yanntotchoun/Multi-Sensor-Node/PCB/conn&Buttons.kicad_sch

## KiCad design PCB/conn&Buttons.kicad_sch (2026-09-08)

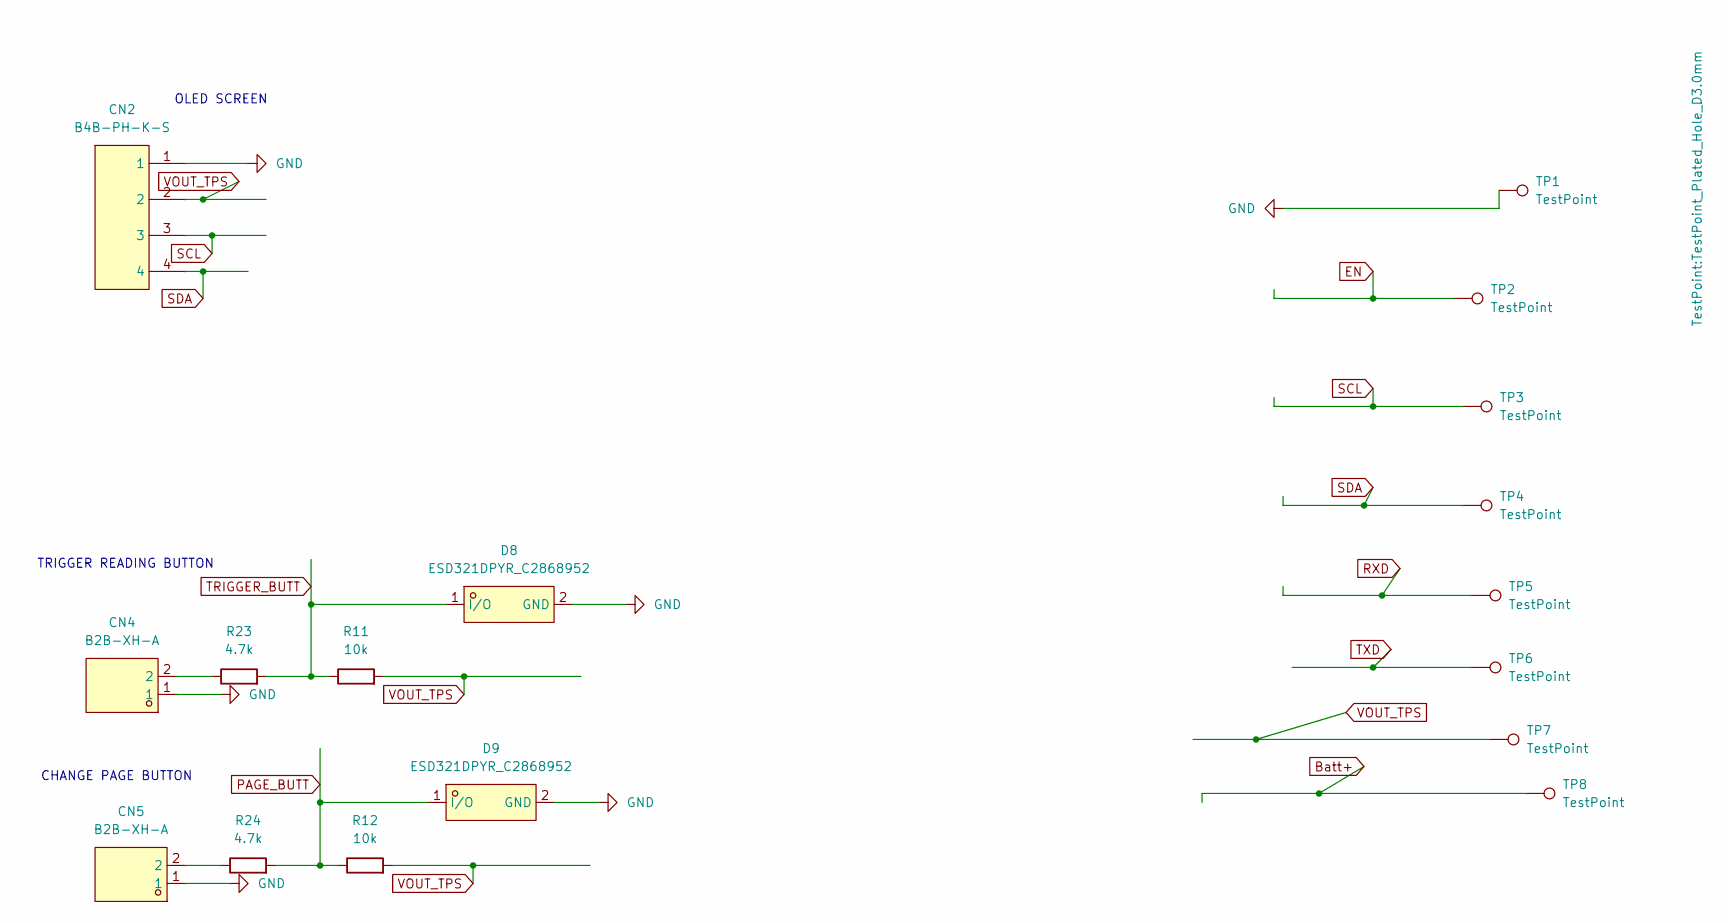
[picture p1: schematic conn&Buttons.kicad_sch]

Parts:
CN2: B4B-PH-K-S; CONN-TH_B4B-PH-K-S; MPN B4B-PH-K-S(LF)(SN); LCSC Part C131334
CN4, CN5: B2B-XH-A; CONN-TH_B2B-XH-A-LF-SN; MPN B2B-XH-A(LF)(SN); LCSC Part C158012
D8, D9: ESD321DPYR_C2868952; X1SON-2_L1.0-W0.6-P0.65-RD-1; MPN ESD321DPYR; LCSC Part C2868952
R11, R12: 10k; R_Axial_DIN0207_L6.3mm_D2.5mm_P10.16mm_Horizontal; JLCPCB C57436
R23, R24: 4.7k; R_Axial_DIN0207_L6.3mm_D2.5mm_P10.16mm_Horizontal; JLCPCB Part # C58678
TP1: TestPoint; TestPoint_Plated_Hole_D3.0mm
TP2, TP3, TP4, TP5, TP6, TP7, TP8: TestPoint; TestPoint_Pad_D2.0mm

Connections:
Batt+: TP8.1
EN: TP2.1
GND: CN2.1, CN4.1, CN5.1, D8.2 (GND), D9.2 (GND), TP1.1
unnamed: CN4.2, R23.1
unnamed: CN5.2, R24.1
PAGE_BUTT: D9.1 (I/O), R12.1, R24.2
RXD: TP5.1
SCL: CN2.3, TP3.1
SDA: CN2.4, TP4.1
TRIGGER_BUTT: D8.1 (I/O), R11.1, R23.2
TXD: TP6.1
VOUT_TPS: CN2.2, R11.2, R12.2, TP7.1

Notes on the sheet:
OLED SCREEN
TRIGGER READING BUTTON
CHANGE PAGE BUTTON
