yanntotchoun/Multi-Sensor-Node/PCB/esp32.kicad_sch

## KiCad design PCB/esp32.kicad_sch (2026-09-08)

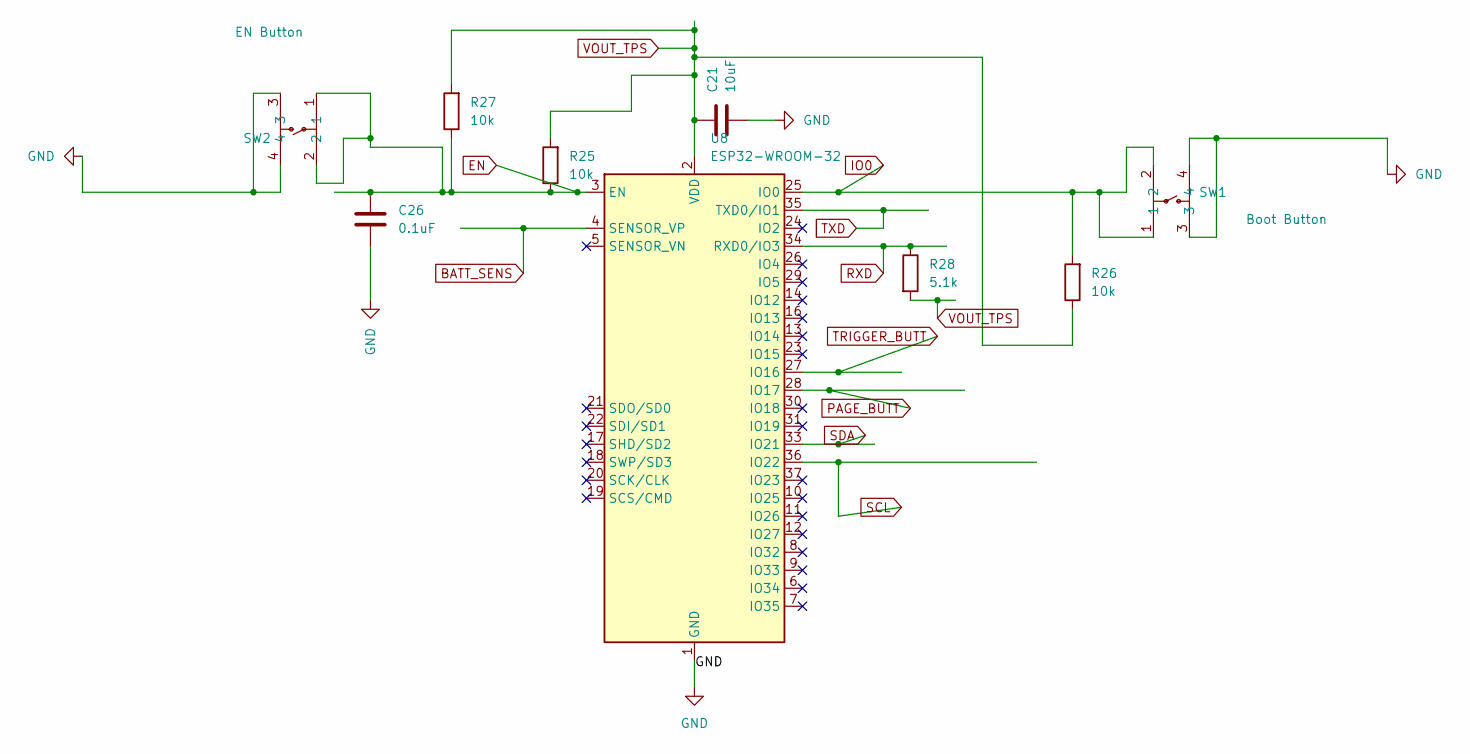
[picture p2: schematic esp32.kicad_sch]

Parts:
C21: 10uF; C_Disc_D6.0mm_W2.5mm_P5.00mm; Part Number FG20X7R1H106KRT06
C26: 0.1uF; C_Disc_D3.8mm_W2.6mm_P2.50mm; Part Number K104K15X7RF5TL2
R25, R26, R27: 10k; R_Axial_DIN0207_L6.3mm_D2.5mm_P10.16mm_Horizontal; JLCPCB C57436
R28: 5.1k; RES-TH_BD2.3-L6.5-P10.50-D0.5; LCSC Part # C714010
SW1: Boot Button; SW-TH_4P-L12.0-W12.0-P5.00-LS12.5; MPN TS1103S-12x12x7.5DIP; LCSC Part C48677982
SW2: EN Button; SW-TH_4P-L12.0-W12.0-P5.00-LS12.5; MPN TS1103S-12x12x7.5DIP; LCSC Part C48677982
U8: ESP32-WROOM-32

Connections:
BATT_SENS: U8.4 (SENSOR_VP)
EN: C26.1, R25.1, R27.1, SW2.1, SW2.2, U8.3 (EN)
GND: C21.2, C26.2, SW1.3, SW1.4, SW2.3, SW2.4, U8.1 (GND), U8.15 (GND), U8.38 (GND), U8.39 (GND)
IO0: R26.2, SW1.1, SW1.2, U8.25 (IO0)
PAGE_BUTT: U8.28 (IO17)
RXD: R28.1, U8.34 (RXD0/IO3)
SCL: U8.36 (IO22)
SDA: U8.33 (IO21)
TRIGGER_BUTT: U8.27 (IO16)
TXD: U8.35 (TXD0/IO1)
VOUT_TPS: C21.1, R25.2, R26.1, R27.2, R28.2, U8.2 (VDD)
