yanntotchoun/Multi-Sensor-Node/PCB/peripherals.kicad_sch

## KiCad design PCB/peripherals.kicad_sch (2026-09-08)

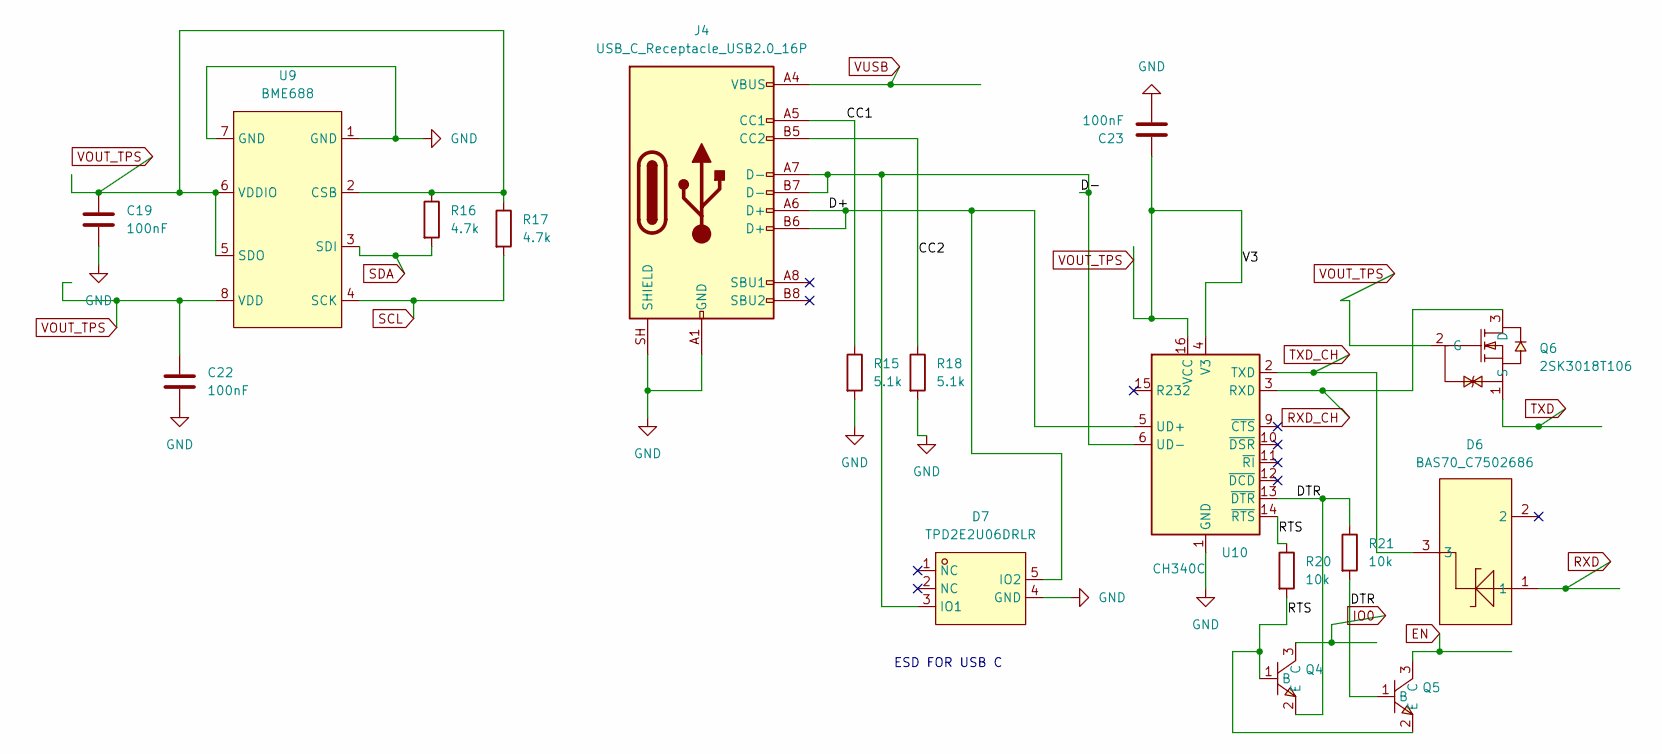
[picture p3: schematic peripherals.kicad_sch]

Parts:
C19, C22, C23: 100nF; C_0402_1005Metric
D6: BAS70_C7502686; SOT-23-3_L2.9-W1.3-P1.90-LS2.4-BL-1; MPN BAS70; LCSC Part C7502686
D7: TPD2E2U06DRLR; SOT-553-5_L1.6-W1.2-P0.50-LS1.6-TL-1; MPN TPD2E2U06DRLR; LCSC Part C1972959
J4: USB_C_Receptacle_USB2.0_16P; USB-C-SMD_TYPE-C-16PIN-2MD-073; LCSC PArt # C2765186
Q4, Q5: SS8050-G_C3199946; SOT-23-3_L2.9-W1.5-P1.90-LS2.6-BR; MPN SS8050-G; LCSC Part C3199946
Q6: 2SK3018T106; SOT-323_L2.0-W1.3-P1.30-LS2.1-TR; MPN 2SK3018T106; LCSC Part C113315
R15, R18: 5.1k; RES-TH_BD2.3-L6.5-P10.50-D0.5; LCSC Part # C714010
R16, R17: 4.7k; R_Axial_DIN0207_L6.3mm_D2.5mm_P10.16mm_Horizontal; JLCPCB Part # C58678
R20, R21: 10k; R_Axial_DIN0207_L6.3mm_D2.5mm_P10.16mm_Horizontal; JLCPCB C57436
U9: BME688; IC_BME688; Part Number BME688; JLCPCB Part # C3664478
U10: CH340C; SOIC-16_3.9x9.9mm_P1.27mm; LCSC Part Number C84681

Connections:
CC1: J4.A5 (CC1), R15.1
CC2: J4.B5 (CC2), R18.1
D+: D7.5 (IO2), J4.A6 (D+), J4.B6 (D+), U10.5 (UD+)
D-: D7.3 (IO1), J4.A7 (D-), J4.B7 (D-), U10.6 (UD-)
DTR: Q4.2 (E), Q5.1 (B), R21.1, R21.2, U10.13 (~DTR)
EN: Q5.3 (C)
GND: C19.2, C22.2, C23.2, D7.4 (GND), J4.A1 (GND), J4.A12 (GND), J4.B1 (GND), J4.B12 (GND), J4.SH (SHIELD), R15.2, R18.2, U9.1 (GND), U9.7 (GND), U10.1 (GND)
IO0: Q4.3 (C)
RTS: Q4.1 (B), Q5.2 (E), R20.1, R20.2, U10.14 (~RTS)
RXD: D6.1
RXD_CH: Q6.3 (D), U10.3 (RXD)
SCL: R17.2, U9.4 (SCK)
SDA: R16.2, U9.3 (SDI)
TXD: Q6.1 (S)
TXD_CH: D6.3, U10.2 (TXD)
VOUT_TPS: C19.1, C22.1, C23.1, Q6.2 (G), R16.1, R17.1, U9.2 (CSB), U9.5 (SDO), U9.6 (VDDIO), U9.8 (VDD), U10.4 (V3), U10.16 (VCC)
VUSB: J4.A4 (VBUS), J4.A9 (VBUS), J4.B4 (VBUS), J4.B9 (VBUS)

Notes on the sheet:
ESD FOR USB C
