yanntotchoun/Multi-Sensor-Node/PCB/power.kicad_sch

## KiCad design PCB/power.kicad_sch (2026-09-08)

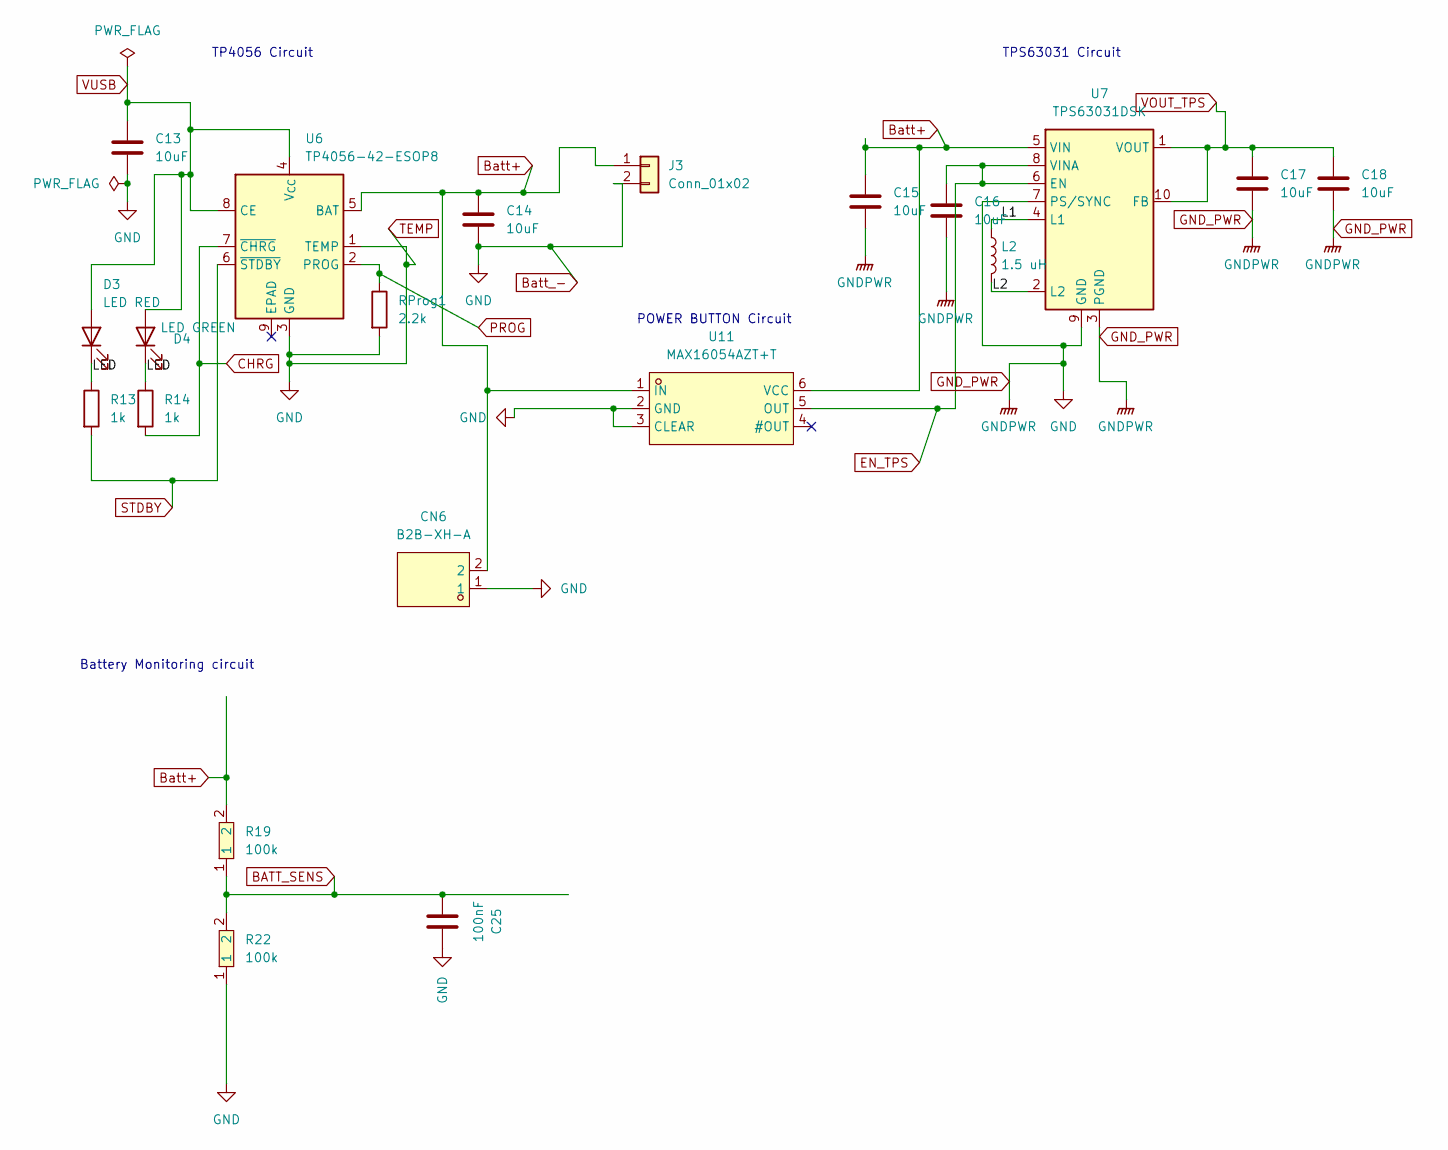
[picture p4: schematic power.kicad_sch]

Parts:
C13, C15, C16, C17, C18: 10uF; C1206; Part Number CL31A106KBHNNNE; LCSC Part # C13585
C14: 10uF; C_Disc_D6.0mm_W2.5mm_P5.00mm; Part Number FG20X7R1H106KRT06
C25: 100nF; C_0402_1005Metric
CN6: B2B-XH-A; CONN-TH_B2B-XH-A-LF-SN; MPN B2B-XH-A(LF)(SN); LCSC Part C158012
D3: LED RED; REDLED0603-FD; LCSC Part # C19171390
D4: LED GREEN; LED0603-RD_GREEN; LCSC Part # C965804
J3: Conn_01x02; CONN-TH_S2B-PH-K-S-GW; LCSC Part # C157932
L2: 1.5 uH; Inductor_SMDL_0806_2016Metric; Part Number DFE201610P-1R5M=P2
R13: 1k; R_Axial_DIN0207_L6.3mm_D2.5mm_P7.62mm_Horizontal; Part number CF14JT1K00
R14: 1k; R_Axial_DIN0207_L6.3mm_D2.5mm_P7.62mm_Horizontal; Part number CF14JT1K00; JLCPCB C2441284
R19, R22: 100k; R0402; MPN RC0402FR-07100KL; LCSC Part C60491
RProg1: 2.2k; R_Axial_DIN0204_L3.6mm_D1.6mm_P5.08mm_Horizontal; LCSC Part # C1779750
U6: TP4056-42-ESOP8; SOIC-8-1EP_3.9x4.9mm_P1.27mm_EP2.41x3.3mm_ThermalVias
U7: TPS63031DSK; WSON-10-1EP_2.5x2.5mm_P0.5mm_EP1.2x2mm
U11: MAX16054AZT+T; TSOT-23-6_L2.9-W1.6-P0.95-LS2.8-TL; MPN MAX16054AZT+T; LCSC Part C79401

Connections:
BATT_SENS: C25.1, R19.1, R22.2
Batt+: C14.1, C15.1, CN6.2, J3.1, R19.2, U6.5 (BAT), U7.5 (VIN), U11.1 (IN), U11.6 (VCC)
Batt_-: C13.2, C14.2, C15.2, C16.2, C17.2, C18.2, C25.2, CN6.1, J3.2, R22.1, RProg1.2, U6.1 (TEMP), U6.3 (GND), U7.3 (PGND), U7.7 (PS/SYNC), U7.9 (GND), U7.11 (PGND), U11.2 (GND), U11.3 (CLEAR)
CHRG: R14.2, U6.7 (~CHRG)
EN_TPS: C16.1, U7.6 (EN), U7.8 (VINA), U11.5 (OUT)
L1: L2.1, U7.4 (L1)
L2: L2.2, U7.2 (L2)
LED: D3.1 (K), D4.1 (K), R13.1, R14.1
PROG: RProg1.1, U6.2 (PROG)
STDBY: R13.2, U6.6 (~STDBY)
VOUT_TPS: C17.1, C18.1, U7.1 (VOUT), U7.10 (FB)
VUSB: C13.1, D3.2 (A), D4.2 (A), U6.4 (V_{CC}), U6.8 (CE)

Notes on the sheet:
Battery Monitoring circuit
TPS63031 Circuit
TP4056 Circuit
POWER BUTTON Circuit
